sarah-64/Class-D-Audio-Amplifier/block-diagram.JPG

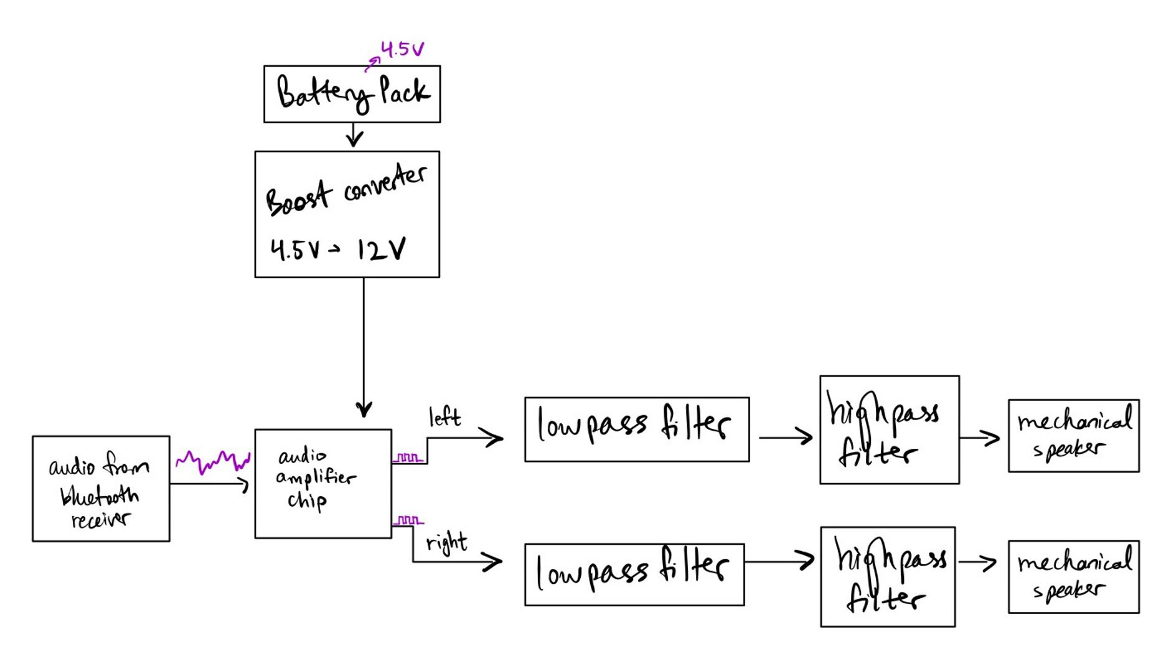
block-diagram.JPG
