sarah-64/Class-D-Audio-Amplifier/Bode Plot.png

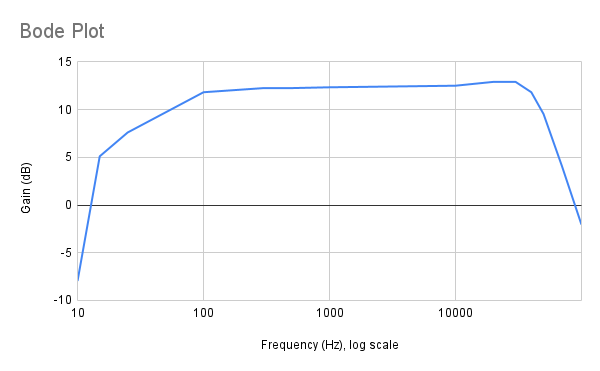
Bode Plot.png
