sarah-64/Class-D-Audio-Amplifier/class-d_speaker.asc

C1: cap; 0.33µ
C2: polcap; 470µ
L1: ind; 20µ
M1: pmos; RSR015P06
M2: nmos; QS6K1
R1: res; 8
U1: UniversalOpAmp2
V1: voltage; 12
V2: voltage; 12
V4: voltage; SINE(0 7.5 1k 0 0 0 0)
V5: voltage; PULSE(-10 10 5u 25u 25u 0u 50u)
X1: deadtime
Named nets: 0, vo, vcc, vee, vpwm, vgp, vgn, vsin, vtr
.tran 0 4000u
.meas tran PS avg -(10*I(V1)+10*I(V2))
.meas tran PL avg V(vo)*I(R1)
.meas tran Efficiency param PL/PS
Dead time control circuit
