sarah-64/Class-D-Audio-Amplifier/speaker_101b.kicad_pcb

## KiCad design speaker_101b.kicad_pcb (2024-12-10)

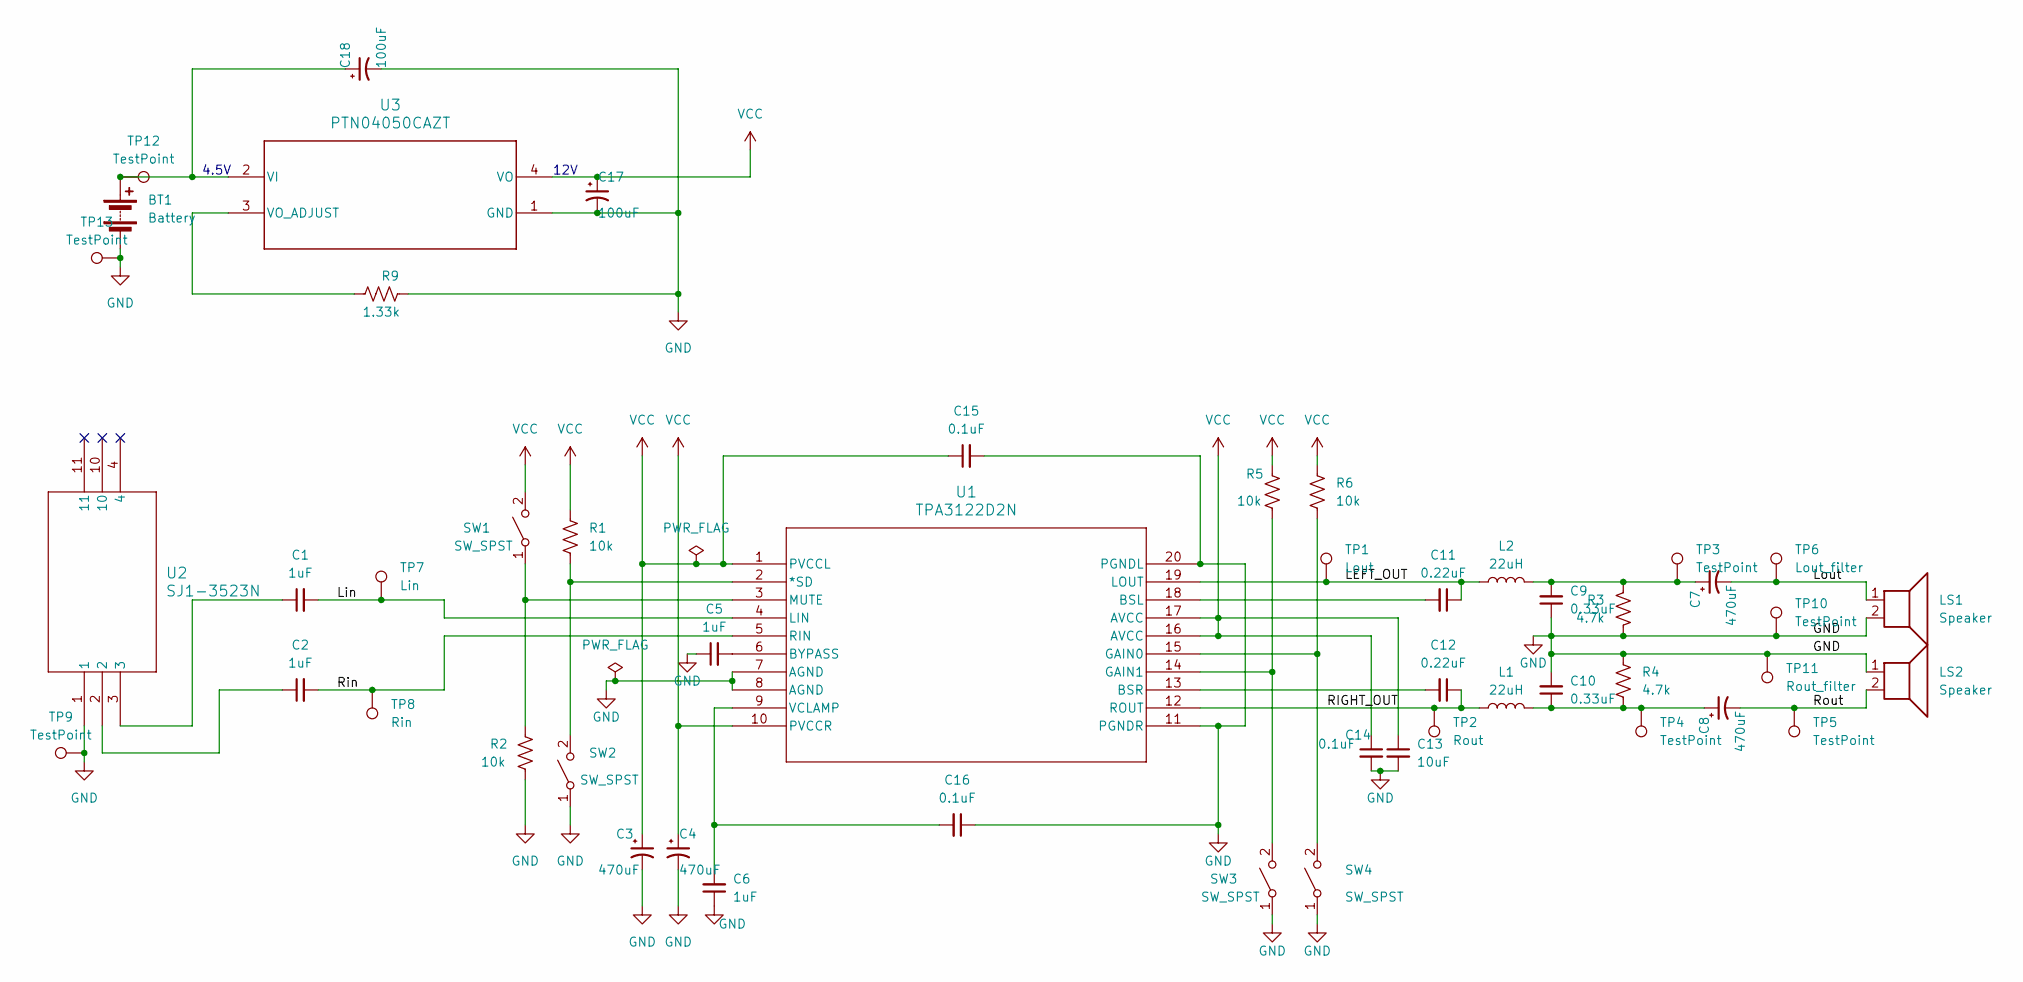
[picture p3: schematic speaker_101b.kicad_sch]

Parts:
BT1: Battery; R_1206_3216Metric_Pad1.30x1.75mm_HandSolder
C1, C2, C5, C6: 1uF; CAP_CL10_SAM
C3, C4, C7, C8: 470uF; CAP_EEE_J16_PAN
C9, C10: 0.33uF; CAP_CL10_SAM
C11, C12: 0.22uF; CAP_GCM155_MUR
C13: 10uF; CAP_CL10_SAM
C14: 0.1uF; CAP_CL10_SAM
C15, C16: 0.1uF; CC0805N_YAG
C17, C18: 100uF; CAP_CL10_SAM
L1, L2: 22uH; L_1206_3216Metric
LS1, LS2: Speaker; R_1206_3216Metric
R1, R2, R5, R6: 10k; R_1206_3216Metric
R3, R4: 4.7k; R_1206_3216Metric
R9: 1.33k; R_1206_3216Metric
SW1, SW2, SW3, SW4: SW_SPST; R_1206_3216Metric
TP1: Lout; TestPoint_Pad_3.0x3.0mm
TP2: Rout; TestPoint_Pad_3.0x3.0mm
TP3, TP4, TP5, TP9, TP10, TP12, TP13: TestPoint; TestPoint_Pad_3.0x3.0mm
TP6: Lout_filter; TestPoint_Pad_3.0x3.0mm
TP7: Lin; TestPoint_Pad_3.0x3.0mm
TP8: Rin; TestPoint_Pad_3.0x3.0mm
TP11: Rout_filter; TestPoint_Pad_3.0x3.0mm
U1: TPA3122D2N; N20
U2: SJ1-3523N; SJ1-3523N_CUD
U3: PTN04050CAZT; EUV0004A

Connections:
/LEFT_OUT: C11.1, L2.1, TP1.1, U1.19 (LOUT)
/Lin: C1.2, TP7.1, U1.4 (LIN)
/Lout: C7.2, LS1.1, TP6.1
/RIGHT_OUT: C12.1, L1.1, TP2.1, U1.12 (ROUT)
/Rin: C2.2, TP8.1, U1.5 (RIN)
/Rout: C8.2, LS2.2, TP5.1
GND: BT1.2 (-), C3.2, C4.2, C5.1, C6.1, C9.1, C10.2, C13.2, C14.2, C15.2, C16.1, C17.2, C18.2, LS1.2, LS2.1, R2.2, R3.2, R4.1, R9.2, SW2.1 (A), SW3.1 (A), SW4.1 (A), TP9.1, TP10.1, TP11.1, TP13.1, U1.7 (AGND), U1.8 (AGND), U1.11 (PGNDR), U1.20 (PGNDL), U2.1, U3.1 (GND)
unnamed: BT1.1 (+), C18.1, TP12.1, U3.2 (VI)
unnamed: C1.1, U2.3
unnamed: C2.1, U2.2
unnamed: C7.1, C9.2, L2.2, R3.1, TP3.1
unnamed: C8.1, C10.1, L1.2, R4.2, TP4.1
unnamed: R2.1, SW1.1 (A), U1.3 (MUTE)
unnamed: R1.2, SW2.2 (B), U1.2 (*SD)
unnamed: R5.2, SW3.2 (B), U1.14 (GAIN1)
unnamed: R6.2, SW4.2 (B), U1.15 (GAIN0)
unnamed: C11.2, U1.18 (BSL)
unnamed: C12.2, U1.13 (BSR)
unnamed: C5.2, U1.6 (BYPASS)
unnamed: C6.2, C16.2, U1.9 (VCLAMP)
unnamed: R9.1, U3.3 (VO_ADJUST)
VCC: C3.1, C4.1, C13.1, C14.1, C15.1, C17.1, R1.1, R5.1, R6.1, SW1.2 (B), U1.1 (PVCCL), U1.10 (PVCCR), U1.16 (AVCC), U1.17 (AVCC), U3.4 (VO)

Notes on the sheet:
4.5V
12V

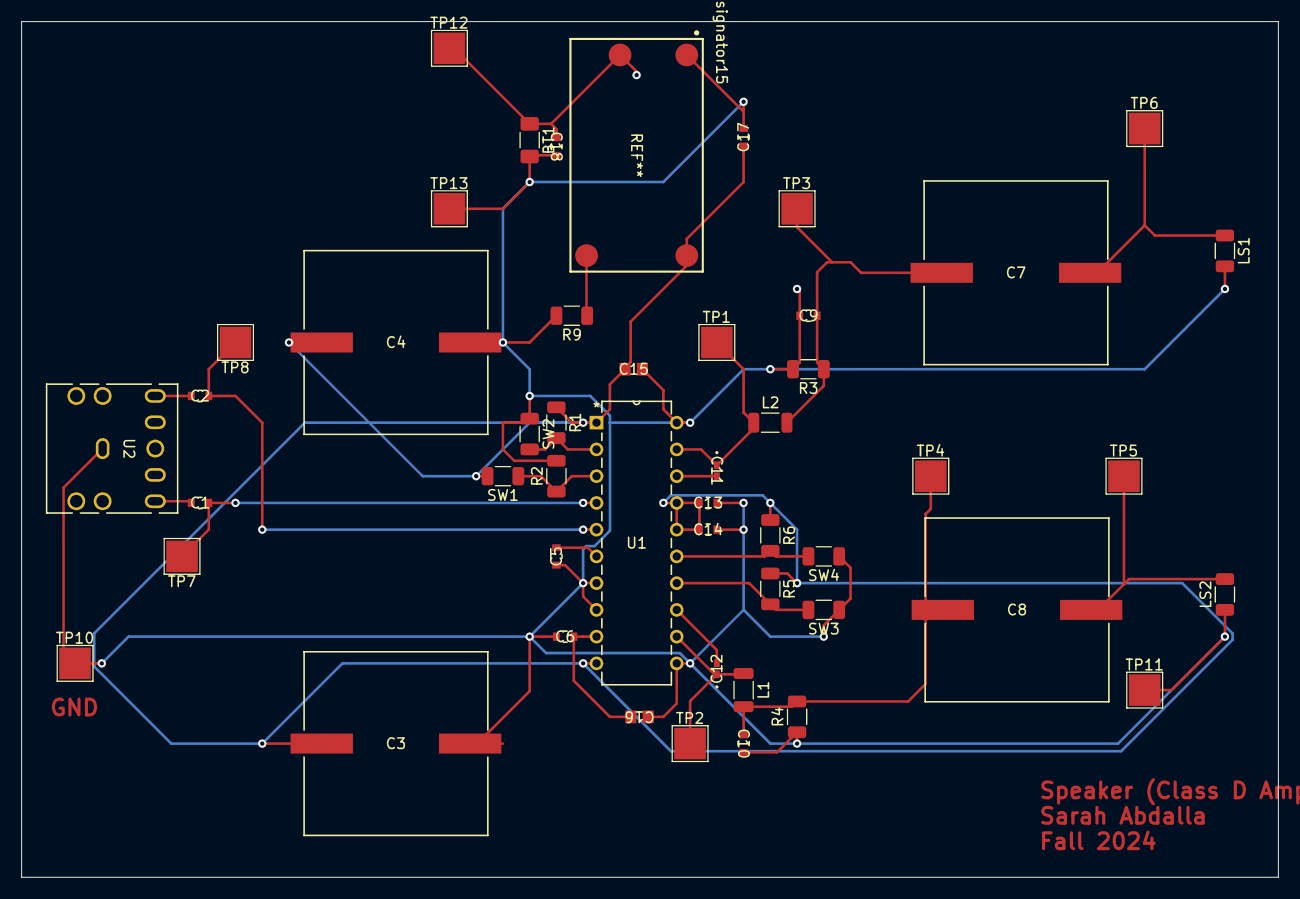
[picture p4: board speaker_101b.kicad_pcb from above]

Board: 2 copper layers, 119.4 x 81.3 mm, 48 parts (0 on the bottom side), 21 nets.
